grkacprzak/USBHUB_2514B/USBHUB_2514B.kicad_pcb

## KiCad design USBHUB_2514B.kicad_pcb (2024-10-07)

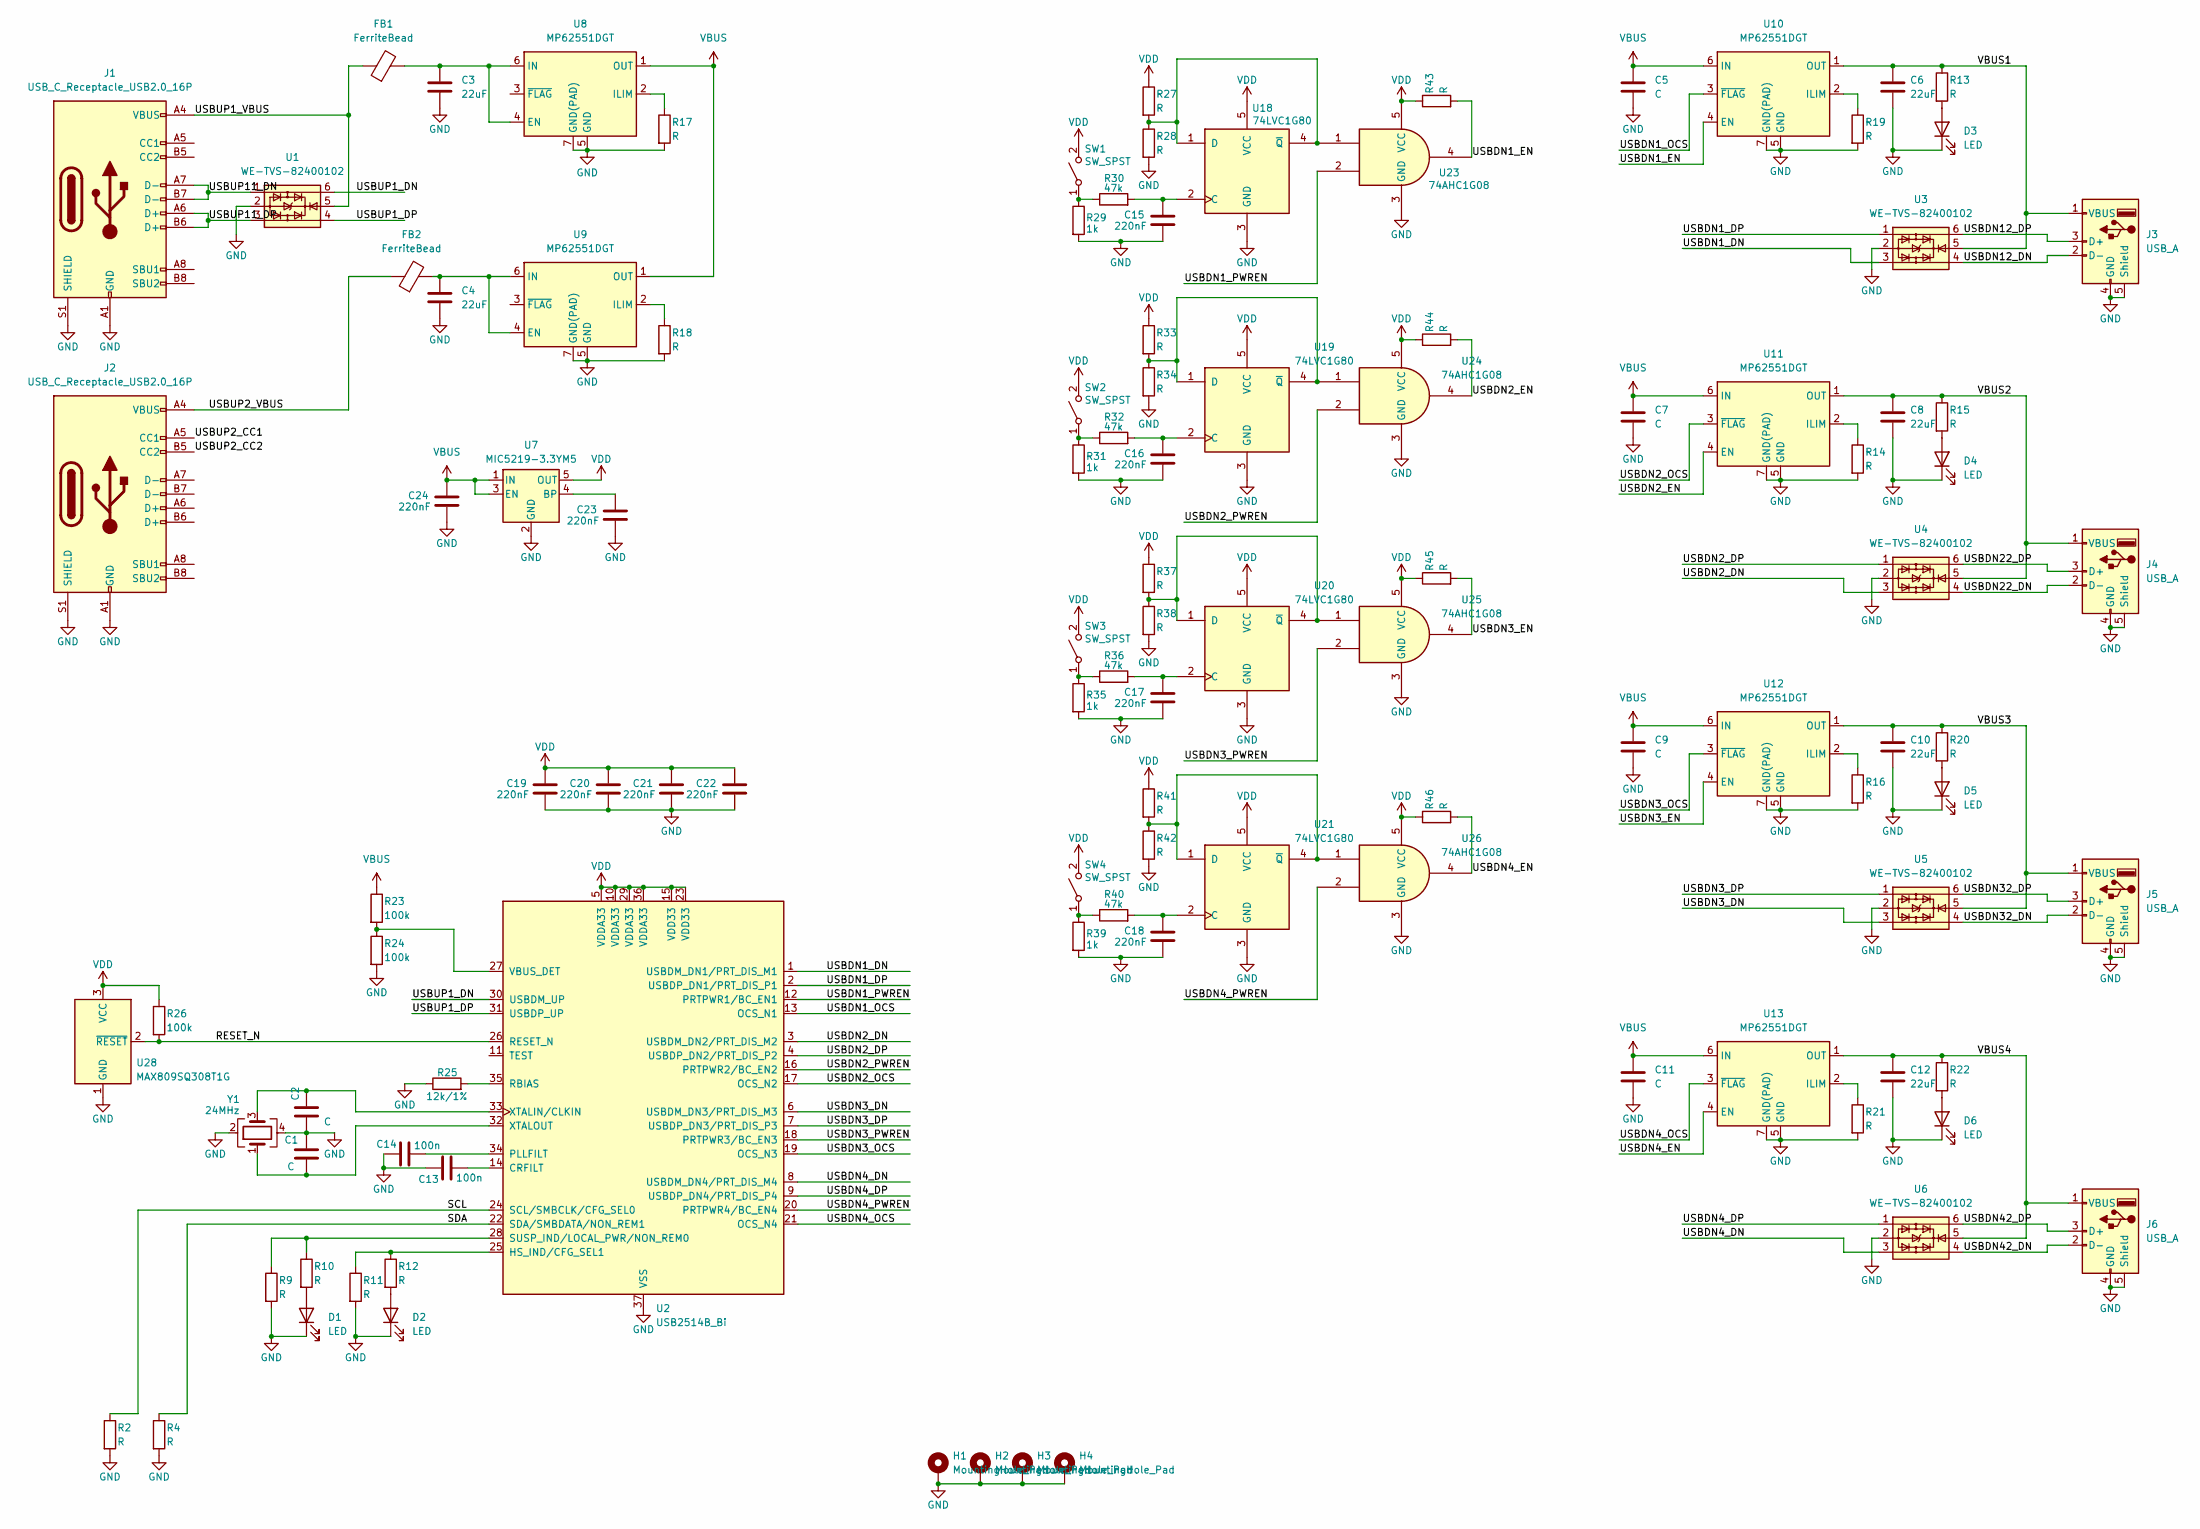
[picture p1: schematic USBHUB_2514B.kicad_sch]

Parts:
C1, C2, C5, C7, C9, C11: C; C_0402_1005Metric
C3, C4, C6, C8, C10, C12: 22uF; C_0805_2012Metric
C13, C14: 100n; C_0402_1005Metric
C15, C16, C17, C18, C19, C20, C21, C22, C23, C24: 220nF; C_0402_1005Metric
D1, D2, D3, D4, D5, D6: LED; LED_0603_1608Metric
FB1, FB2: FerriteBead; L_0805_2012Metric
H1, H2, H3, H4: MountingHole_Pad; MountingHole_2.5mm_Pad
J1, J2: USB_C_Receptacle_USB2.0_16P; USB_C_Receptacle_Wuerth_629722000214
J3, J4, J5, J6: USB_A; USB_A_Wuerth_614004185023_Vertical
R2, R4, R9, R10, R11, R12, R13, R14, R15, R16, R17, R18, R19, R20, R21, R22, R27, R28, R33, R34, R37, R38, R41, R42, R43, R44, R45, R46: R; R_0402_1005Metric
R23, R24, R26: 100k; R_0402_1005Metric
R25: 12k/1%; R_0402_1005Metric
R29, R31, R35, R39: 1k; R_0402_1005Metric
R30, R32, R36, R40: 47k; R_0402_1005Metric
SW1, SW2, SW3, SW4: SW_SPST; SW_PUSH_6mm_H9.5mm
U1, U3, U4, U5, U6: WE-TVS-82400102; SOT-363_SC-70-6
U2: USB2514B_Bi; QFN-36-1EP_6x6mm_P0.5mm_EP3.7x3.7mm
U7: MIC5219-3.3YM5; SOT-23-5
U8, U9, U10, U11, U12, U13: MP62551DGT; DFN-6-1EP_2x2mm_P0.65mm_EP1x1.6mm
U18, U19, U20, U21: 74LVC1G80; SOT-353_SC-70-5
U23, U24, U25, U26: 74AHC1G08; SOT-353_SC-70-5
U28: MAX809SQ308T1G; SOT-323_SC-70
Y1: 24MHz; Crystal_SMD_2520-4Pin_2.5x2.0mm

Connections:
/RESET_N: R26.2, U2.26 (RESET_N), U28.2 (~RESET)
/SCL: R2.1, U2.24 (SCL/SMBCLK/CFG_SEL0)
/SDA: R4.1, U2.22 (SDA/SMBDATA/NON_REM1)
/USBDN1_DN: U2.1 (USBDM_DN1/PRT_DIS_M1), U3.3
/USBDN1_DP: U2.2 (USBDP_DN1/PRT_DIS_P1), U3.1
/USBDN1_EN: R43.2, U10.4 (EN), U23.4
/USBDN1_OCS: U2.13 (OCS_N1), U10.3 (~FLAG)
/USBDN1_PWREN: U2.12 (PRTPWR1/BC_EN1), U23.2
/USBDN2_DN: U2.3 (USBDM_DN2/PRT_DIS_M2), U4.3
/USBDN2_DP: U2.4 (USBDP_DN2/PRT_DIS_P2), U4.1
/USBDN2_EN: R44.2, U11.4 (EN), U24.4
/USBDN2_OCS: U2.17 (OCS_N2), U11.3 (~FLAG)
/USBDN2_PWREN: U2.16 (PRTPWR2/BC_EN2), U24.2
/USBDN3_DN: U2.6 (USBDM_DN3/PRT_DIS_M3), U5.3
/USBDN3_DP: U2.7 (USBDP_DN3/PRT_DIS_P3), U5.1
/USBDN3_EN: R45.2, U12.4 (EN), U25.4
/USBDN3_OCS: U2.19 (OCS_N3), U12.3 (~FLAG)
/USBDN3_PWREN: U2.18 (PRTPWR3/BC_EN3), U25.2
/USBDN4_DN: U2.8 (USBDM_DN4/PRT_DIS_M4), U6.3
/USBDN4_DP: U2.9 (USBDP_DN4/PRT_DIS_P4), U6.1
/USBDN4_EN: R46.2, U13.4 (EN), U26.4
/USBDN4_OCS: U2.21 (OCS_N4), U13.3 (~FLAG)
/USBDN4_PWREN: U2.20 (PRTPWR4/BC_EN4), U26.2
/USBDN12_DN: J3.2 (D-), U3.4
/USBDN12_DP: J3.3 (D+), U3.6
/USBDN22_DN: J4.2 (D-), U4.4
/USBDN22_DP: J4.3 (D+), U4.6
/USBDN32_DN: J5.2 (D-), U5.4
/USBDN32_DP: J5.3 (D+), U5.6
/USBDN42_DN: J6.2 (D-), U6.4
/USBDN42_DP: J6.3 (D+), U6.6
/USBUP1_DN: U1.6, U2.30 (USBDM_UP)
/USBUP1_DP: U1.4, U2.31 (USBDP_UP)
/USBUP1_VBUS: FB1.1, J1.A4 (VBUS), J1.A9 (VBUS), J1.B4 (VBUS), J1.B9 (VBUS), U1.5
/USBUP2_CC1: J2.A5 (CC1)
/USBUP2_CC2: J2.B5 (CC2)
/USBUP2_VBUS: FB2.1, J2.A4 (VBUS), J2.A9 (VBUS), J2.B4 (VBUS), J2.B9 (VBUS)
/USBUP11_DN: J1.A7 (D-), J1.B7 (D-), U1.1
/USBUP11_DP: J1.A6 (D+), J1.B6 (D+), U1.3
/VBUS1: C6.1, J3.1 (VBUS), R13.1, U3.5, U10.1 (OUT)
/VBUS2: C8.1, J4.1 (VBUS), R15.1, U4.5, U11.1 (OUT)
/VBUS3: C10.1, J5.1 (VBUS), R20.1, U5.5, U12.1 (OUT)
/VBUS4: C12.1, J6.1 (VBUS), R22.1, U6.5, U13.1 (OUT)
GND: C1.1, C2.1, C3.2, C4.2, C5.2, C6.2, C7.2, C8.2, C9.2, C10.2, C11.2, C12.2, C13.2, C14.2, C15.2, C16.2, C17.2, C18.2, C19.2, C20.2, C21.2, C22.2, C23.2, C24.2, D1.1 (K), D2.1 (K), D3.1 (K), D4.1 (K), D5.1 (K), D6.1 (K), H1.1, H2.1, H3.1, H4.1, J1.A1 (GND), J1.A12 (GND), J1.B1 (GND), J1.B12 (GND), J1.S1 (SHIELD), J2.A1 (GND), J2.A12 (GND), J2.B1 (GND), J2.B12 (GND), J2.S1 (SHIELD), J3.4 (GND), J3.5 (Shield), J4.4 (GND), J4.5 (Shield), J5.4 (GND), J5.5 (Shield), J6.4 (GND), J6.5 (Shield), R2.2, R4.2, R9.2, R11.2, R14.2, R16.2, R17.2, R18.2, R19.2, R21.2, R24.2, R25.1, R28.2, R29.2, R31.2, R34.2, R35.2, R38.2, R39.2, R42.2, U1.2, U2.37 (VSS), U3.2, U4.2, U5.2, U6.2, U7.2 (GND), U8.5 (GND), U8.7 (GND(PAD)), U9.5 (GND), U9.7 (GND(PAD)), U10.5 (GND), U10.7 (GND(PAD)), U11.5 (GND), U11.7 (GND(PAD)), U12.5 (GND), U12.7 (GND(PAD)), U13.5 (GND), U13.7 (GND(PAD)), U18.3 (GND), U19.3 (GND), U20.3 (GND), U21.3 (GND), U23.3 (GND), U24.3 (GND), U25.3 (GND), U26.3 (GND), U28.1 (GND), Y1.2, Y1.4
unnamed: D1.2 (A), R10.2
unnamed: D2.2 (A), R12.2
unnamed: D3.2 (A), R13.2
unnamed: D4.2 (A), R15.2
unnamed: D5.2 (A), R20.2
unnamed: D6.2 (A), R22.2
unnamed: R29.1, R30.1, SW1.1 (A)
unnamed: R31.1, R32.1, SW2.1 (A)
unnamed: R35.1, R36.1, SW3.1 (A)
unnamed: R39.1, R40.1, SW4.1 (A)
unnamed: C13.1, U2.14 (CRFILT)
unnamed: R11.1, R12.1, U2.25 (HS_IND/CFG_SEL1)
unnamed: C14.1, U2.34 (PLLFILT)
unnamed: R25.2, U2.35 (RBIAS)
unnamed: R9.1, R10.1, U2.28 (SUSP_IND/LOCAL_PWR/NON_REM0)
unnamed: R23.2, R24.1, U2.27 (VBUS_DET)
unnamed: C2.2, U2.33 (XTALIN/CLKIN), Y1.3
unnamed: C1.2, U2.32 (XTALOUT), Y1.1
unnamed: C23.1, U7.4 (BP)
unnamed: C3.1, FB1.2, U8.4 (EN), U8.6 (IN)
unnamed: R17.1, U8.2 (ILIM)
unnamed: C4.1, FB2.2, U9.4 (EN), U9.6 (IN)
unnamed: R18.1, U9.2 (ILIM)
unnamed: R19.1, U10.2 (ILIM)
unnamed: R14.1, U11.2 (ILIM)
unnamed: R16.1, U12.2 (ILIM)
unnamed: R21.1, U13.2 (ILIM)
unnamed: C15.1, R30.2, U18.2 (C)
unnamed: R27.2, R28.1, U18.1 (D), U18.4 (~Q), U23.1
unnamed: C16.1, R32.2, U19.2 (C)
unnamed: R33.2, R34.1, U19.1 (D), U19.4 (~Q), U24.1
unnamed: C17.1, R36.2, U20.2 (C)
unnamed: R37.2, R38.1, U20.1 (D), U20.4 (~Q), U25.1
unnamed: C18.1, R40.2, U21.2 (C)
unnamed: R41.2, R42.1, U21.1 (D), U21.4 (~Q), U26.1
VBUS: C5.1, C7.1, C9.1, C11.1, C24.1, R23.1, U7.1 (IN), U7.3 (EN), U8.1 (OUT), U9.1 (OUT), U10.6 (IN), U11.6 (IN), U12.6 (IN), U13.6 (IN)
VDD: C19.1, C20.1, C21.1, C22.1, R26.1, R27.1, R33.1, R37.1, R41.1, R43.1, R44.1, R45.1, R46.1, SW1.2 (B), SW2.2 (B), SW3.2 (B), SW4.2 (B), U2.5 (VDDA33), U2.10 (VDDA33), U2.15 (VDD33), U2.23 (VDD33), U2.29 (VDDA33), U2.36 (VDDA33), U7.5 (OUT), U18.5 (VCC), U19.5 (VCC), U20.5 (VCC), U21.5 (VCC), U23.5 (VCC), U24.5 (VCC), U25.5 (VCC), U26.5 (VCC), U28.3 (VCC)

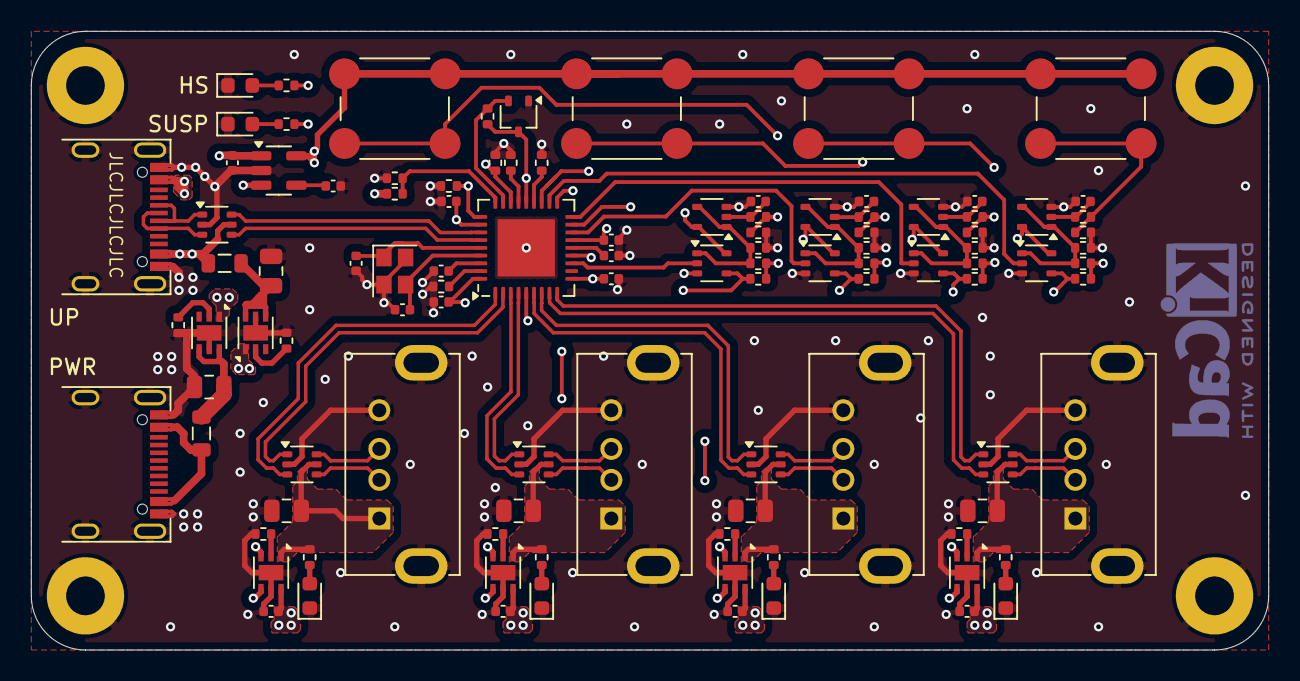
[picture p2: board USBHUB_2514B.kicad_pcb from above]

Board: 4 copper layers, 80.0 x 40.0 mm, 109 parts (0 on the bottom side), 79 nets.
